johofz/Reflow_Oven_V2/Hardware/Reflow_Ofen_V2.kicad_pcb

## KiCad design Hardware/Reflow_Ofen_V2.kicad_pcb (2021-04-04)

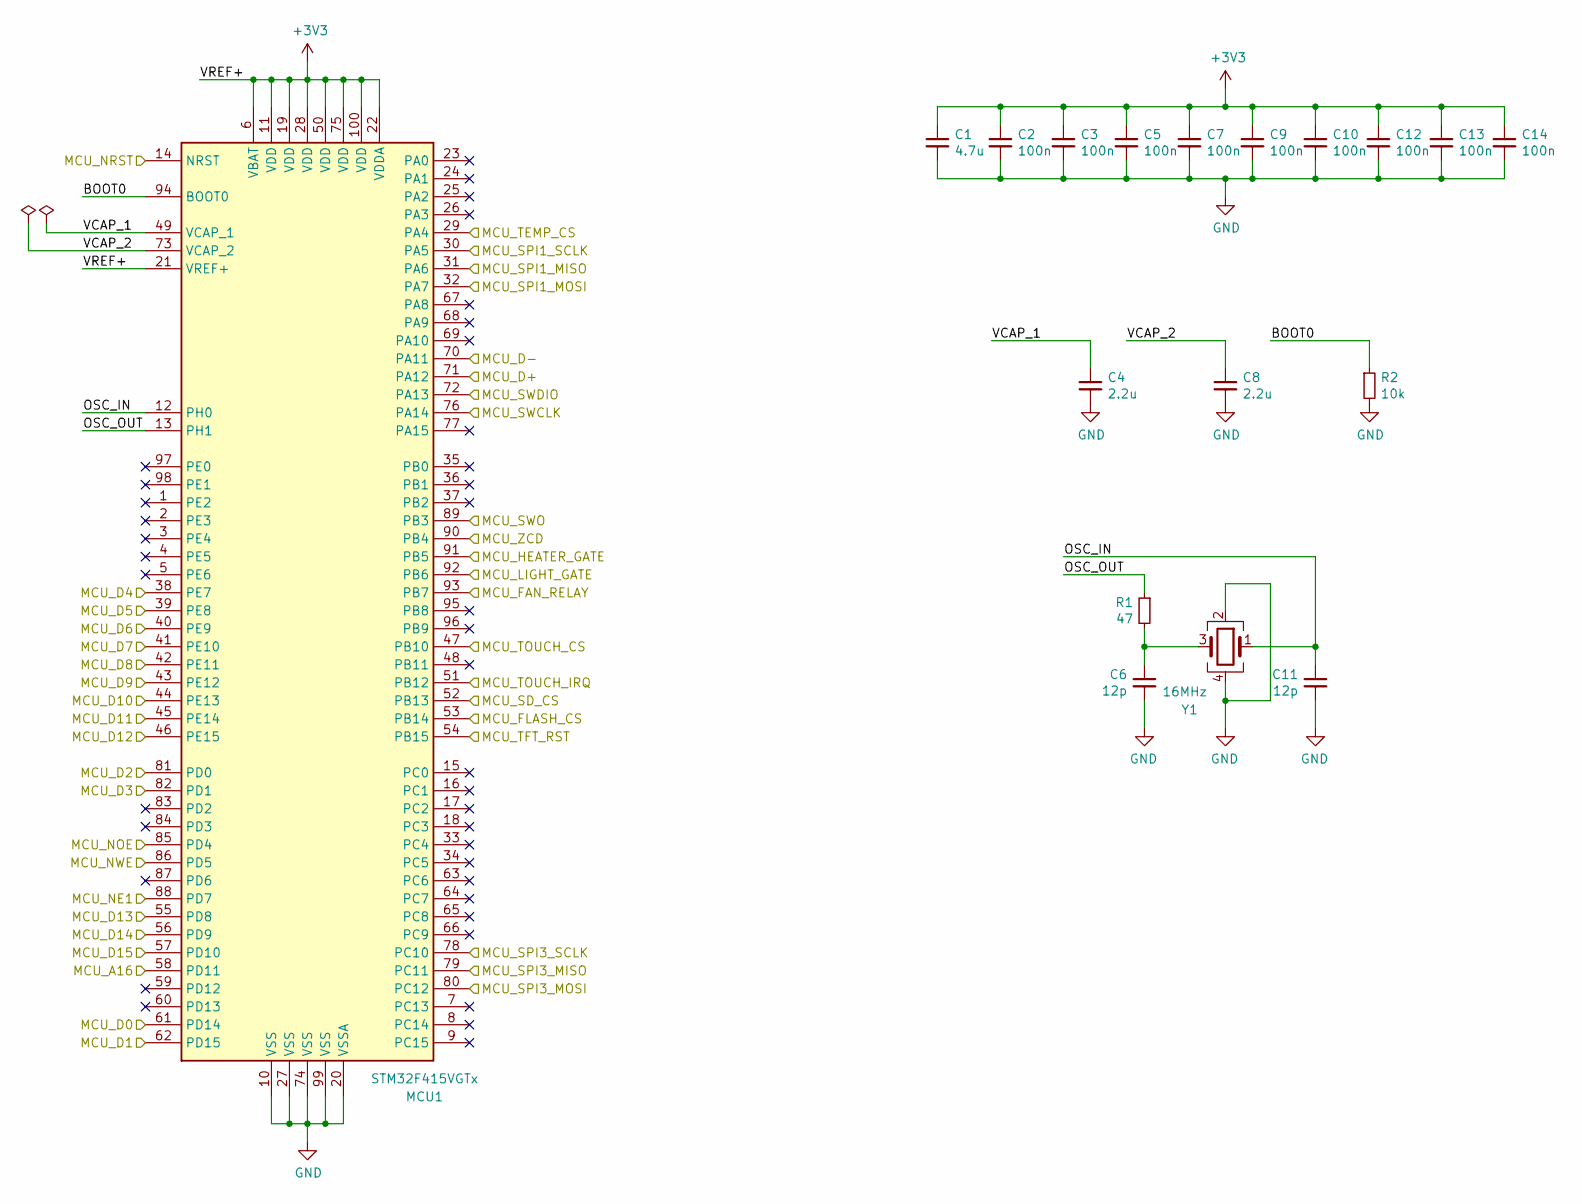
[picture p1: schematic STMF415VGT6.sch]

Parts:
C1: 4.7u; C_0603_1608Metric; LCSC C19666
C2, C3, C5, C7, C9, C10, C12, C13, C14: 100n; C_0402_1005Metric; LCSC C1525
C4, C8: 2.2u; C_0603_1608Metric; LCSC C23630
C6, C11: 12p; C_0402_1005Metric; LCSC C1547
MCU1: STM32F415VGTx; LQFP-100_14x14mm_P0.5mm; LCSC C118210
R1: 47; R_0402_1005Metric; LCSC C25118
R2: 10k; R_0402_1005Metric; LCSC C25744
Y1: 16MHz; Crystal_SMD_3225-4Pin_3.2x2.5mm; LCSC C13738

Connections:
/Connectors/CONN_D+: MCU1.71 (PA12); also elsewhere on the board
/Connectors/CONN_D-: MCU1.70 (PA11); also elsewhere on the board
/Connectors/CONN_NRST: MCU1.14 (NRST); also elsewhere on the board
/Connectors/CONN_SWCLK: MCU1.76 (PA14); also elsewhere on the board
/Connectors/CONN_SWDIO: MCU1.72 (PA13); also elsewhere on the board
/Connectors/CONN_SWO: MCU1.89 (PB3); also elsewhere on the board
/FLASH_CS: MCU1.53 (PB14); also elsewhere on the board
/Power-Control/FAN_GATE: MCU1.93 (PB7); also elsewhere on the board
/Power-Control/HEATER_GATE: MCU1.91 (PB5); also elsewhere on the board
/Power-Control/LIGHT_GATE: MCU1.92 (PB6); also elsewhere on the board
/SD_CS: MCU1.52 (PB13); also elsewhere on the board
/SPI3_MISO: MCU1.79 (PC11); also elsewhere on the board
/SPI3_MOSI: MCU1.80 (PC12); also elsewhere on the board
/SPI3_SCLK: MCU1.78 (PC10); also elsewhere on the board
/STMF415VGT6/BOOT0: MCU1.94 (BOOT0), R2.1
/STMF415VGT6/MCU_A16: MCU1.58 (PD11); also elsewhere on the board
/STMF415VGT6/MCU_D0: MCU1.61 (PD14); also elsewhere on the board
/STMF415VGT6/MCU_D1: MCU1.62 (PD15); also elsewhere on the board
/STMF415VGT6/MCU_D2: MCU1.81 (PD0); also elsewhere on the board
/STMF415VGT6/MCU_D3: MCU1.82 (PD1); also elsewhere on the board
/STMF415VGT6/MCU_D4: MCU1.38 (PE7); also elsewhere on the board
/STMF415VGT6/MCU_D5: MCU1.39 (PE8); also elsewhere on the board
/STMF415VGT6/MCU_D6: MCU1.40 (PE9); also elsewhere on the board
/STMF415VGT6/MCU_D7: MCU1.41 (PE10); also elsewhere on the board
/STMF415VGT6/MCU_D8: MCU1.42 (PE11); also elsewhere on the board
/STMF415VGT6/MCU_D9: MCU1.43 (PE12); also elsewhere on the board
/STMF415VGT6/MCU_D10: MCU1.44 (PE13); also elsewhere on the board
/STMF415VGT6/MCU_D11: MCU1.45 (PE14); also elsewhere on the board
/STMF415VGT6/MCU_D12: MCU1.46 (PE15); also elsewhere on the board
/STMF415VGT6/MCU_D13: MCU1.55 (PD8); also elsewhere on the board
/STMF415VGT6/MCU_D14: MCU1.56 (PD9); also elsewhere on the board
/STMF415VGT6/MCU_D15: MCU1.57 (PD10); also elsewhere on the board
/STMF415VGT6/MCU_NE1: MCU1.88 (PD7); also elsewhere on the board
/STMF415VGT6/MCU_NOE: MCU1.85 (PD4); also elsewhere on the board
/STMF415VGT6/MCU_NWE: MCU1.86 (PD5); also elsewhere on the board
/STMF415VGT6/MCU_SPI1_MISO: MCU1.31 (PA6); also elsewhere on the board
/STMF415VGT6/MCU_SPI1_SCLK: MCU1.30 (PA5); also elsewhere on the board
/STMF415VGT6/MCU_TEMP_CS: MCU1.29 (PA4); also elsewhere on the board
/STMF415VGT6/MCU_TFT_RST: MCU1.54 (PB15); also elsewhere on the board
/STMF415VGT6/MCU_ZCD: MCU1.90 (PB4); also elsewhere on the board
/STMF415VGT6/OSC_IN: C11.1, MCU1.12 (PH0), Y1.1
/STMF415VGT6/OSC_OUT: MCU1.13 (PH1), R1.1
/STMF415VGT6/VCAP_1: C4.1, MCU1.49 (VCAP_1)
/STMF415VGT6/VCAP_2: C8.1, MCU1.73 (VCAP_2)
/TOUCH_CS: MCU1.47 (PB10); also elsewhere on the board
/TOUCH_IRQ: MCU1.51 (PB12); also elsewhere on the board
GND: C1.2, C2.2, C3.2, C4.2, C5.2, C6.2, C7.2, C8.2, C9.2, C10.2, C11.2, C12.2, C13.2, C14.2, MCU1.10 (VSS), MCU1.20 (VSSA), MCU1.27 (VSS), MCU1.74 (VSS), MCU1.99 (VSS), R2.2, Y1.2, Y1.4; also elsewhere on the board
unnamed: C6.1, R1.2, Y1.3

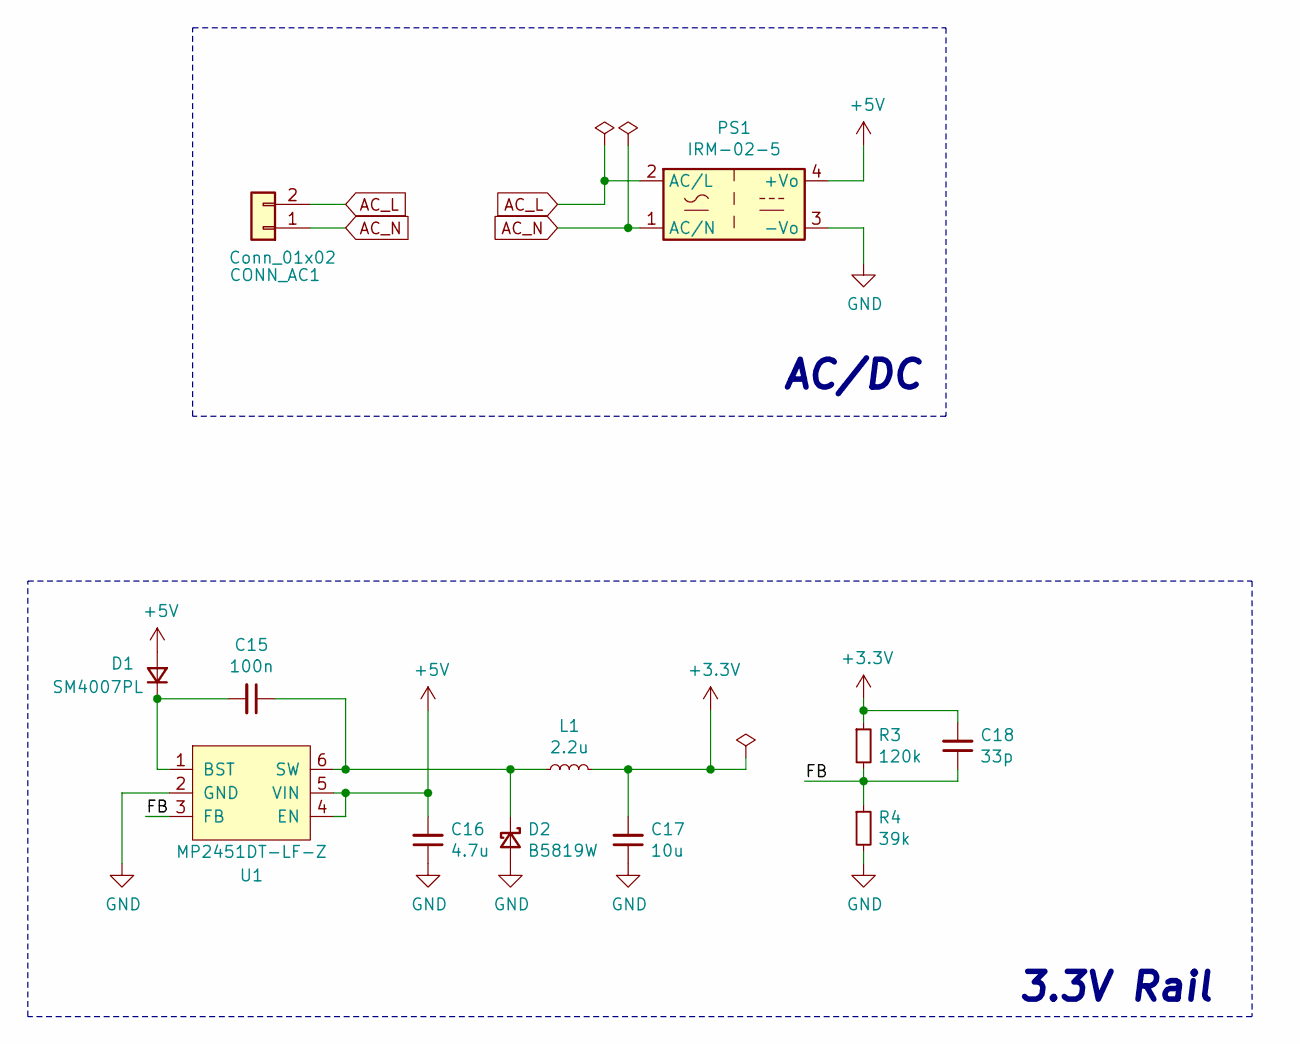
[picture p2: schematic Power.sch]

Parts:
C15: 100n; C_0402_1005Metric; LCSC C1525
C16: 4.7u; C_0805_2012Metric; LCSC C1779
C17: 10u; C_0805_2012Metric; LCSC C15850
C18: 33p; C_0603_1608Metric; LCSC C1663
CONN_AC1: Conn_01x02; TerminalBlock_Wuerth_691311400102_P7.62mm; LCSC C8422
D1: SM4007PL; D_SOD-123F; LCSC C64898
D2: B5819W; D_SOD-123; LCSC C8598
L1: 2.2u; L_Sunlord_MWSA0518_5.4x5.2mm; LCSC C408345
PS1: IRM-02-5; Converter_ACDC_MeanWell_IRM-02-xx_THT
R3: 120k; R_0805_2012Metric; LCSC C17436
R4: 39k; R_0805_2012Metric; LCSC C25826
U1: MP2451DT-LF-Z; TSOT-23-6; LCSC C85285

Connections:
+5V: C16.2, D1.2 (A), PS1.4 (+Vo), U1.4 (EN), U1.5 (VIN); also elsewhere on the board
/Power/FB: C18.1, R3.2, R4.1, U1.3 (FB)
AC_L: CONN_AC1.2, PS1.2 (AC/L); also elsewhere on the board
AC_N: CONN_AC1.1, PS1.1 (AC/N); also elsewhere on the board
GND: C16.1, C17.1, D2.2 (A), PS1.3 (-Vo), R4.2, U1.2 (GND); also elsewhere on the board
unnamed: C15.1, D2.1 (K), L1.1, U1.6 (SW)
unnamed: C15.2, D1.1 (K), U1.1 (BST)

Notes on the sheet:
3.3V Rail
AC/DC

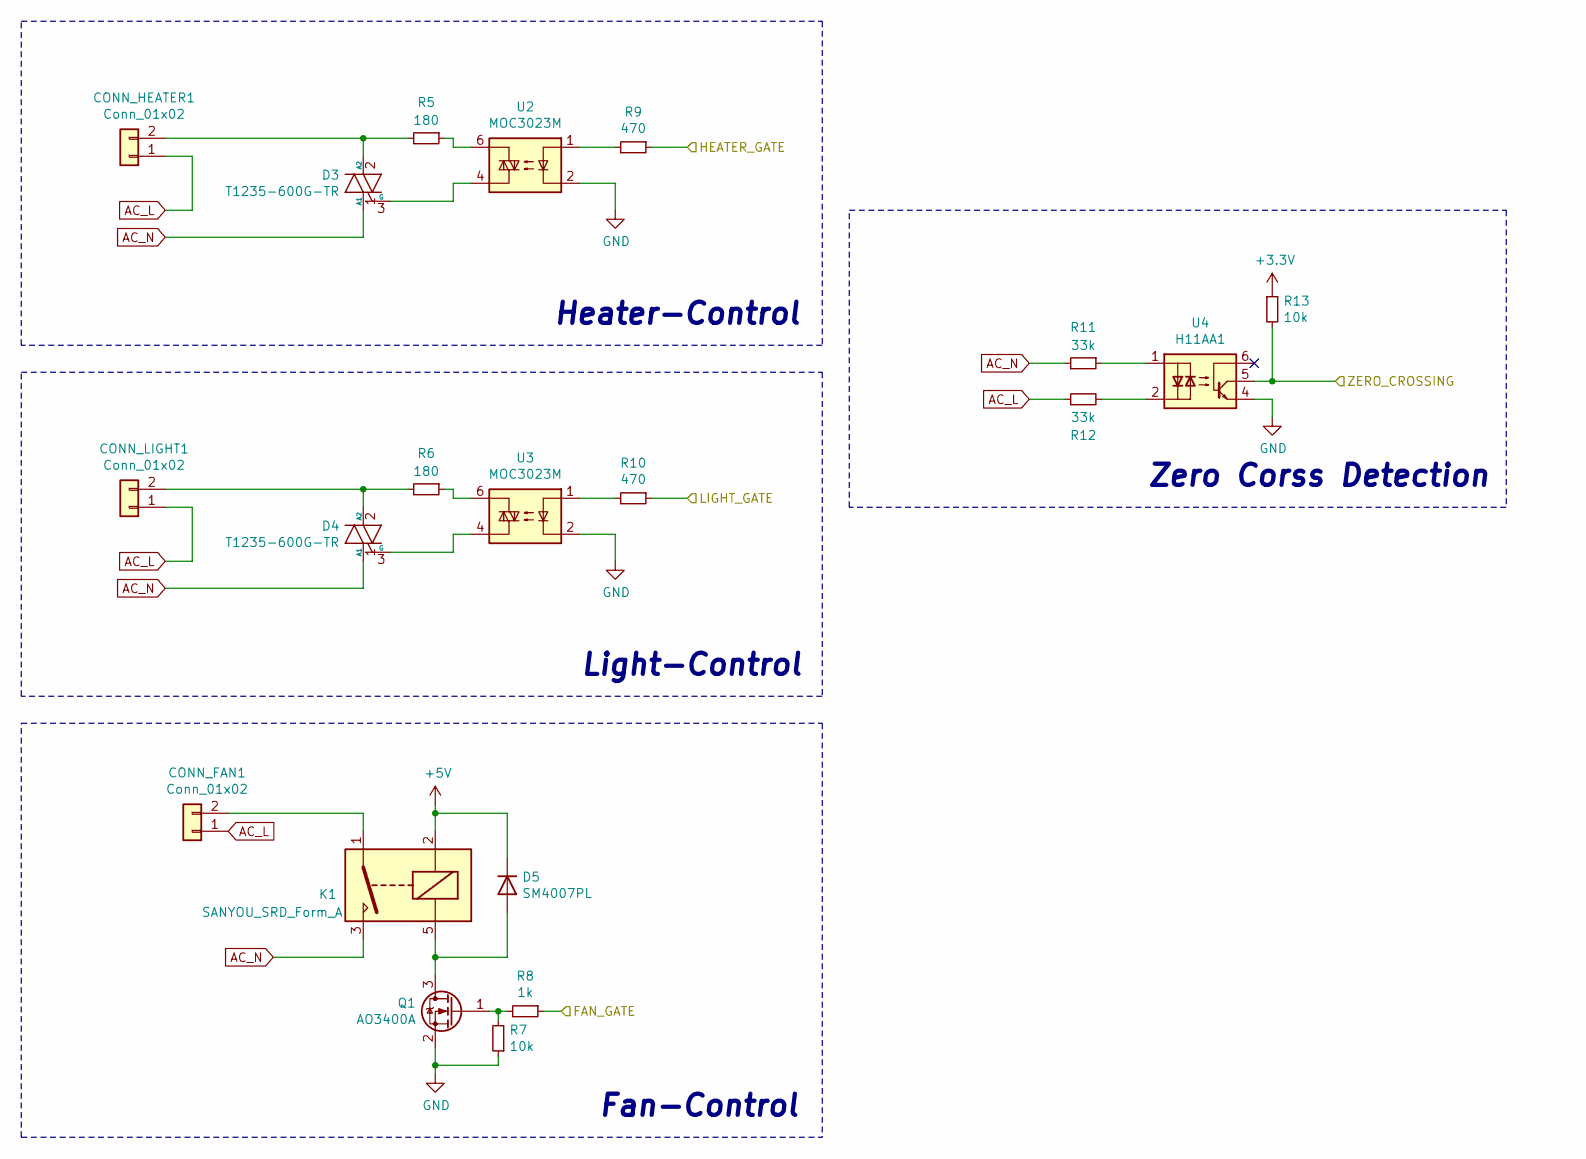
[picture p3: schematic Power-Control.sch]

Parts:
CONN_FAN1: Conn_01x02; TerminalBlock_Wuerth_691311400102_P7.62mm; LCSC C8422
CONN_HEATER1: Conn_01x02; TerminalBlock_Wuerth_691311400102_P7.62mm; LCSC C8422
CONN_LIGHT1: Conn_01x02; TerminalBlock_Wuerth_691311400102_P7.62mm; LCSC C8422
D3: T1235-600G-TR; TO-220-3_Vertical
D4: T1235-600G-TR; TO-263-2; LCSC C155555
D5: SM4007PL; D_SOD-123F; LCSC C64898
K1: SANYOU_SRD_Form_A; Relay_SPST_SANYOU_SRD_Series_Form_A; LCSC C35449
Q1: AO3400A; SOT-23; LCSC C20917
R5, R6: 180; R_0805_2012Metric; LCSC C25270
R7, R13: 10k; R_0603_1608Metric; LCSC C25804
R8: 1k; R_0603_1608Metric; LCSC C21190
R9, R10: 470; R_0603_1608Metric; LCSC C25117
R11, R12: 33k; R_0805_2012Metric; LCSC C17633
U2, U3: MOC3023M; SMDIP-6_W9.53mm; LCSC C40701
U4: H11AA1; SMDIP-6_W9.53mm; LCSC C258253

Connections:
+5V: D5.1 (K), K1.2; also elsewhere on the board
/Power-Control/FAN_GATE: R8.1; also elsewhere on the board
/Power-Control/HEATER_GATE: R9.1; also elsewhere on the board
/Power-Control/LIGHT_GATE: R10.1; also elsewhere on the board
/STMF415VGT6/MCU_ZCD: R13.2, U4.5; also elsewhere on the board
AC_L: CONN_FAN1.1, CONN_HEATER1.1, CONN_LIGHT1.1, R12.1; also elsewhere on the board
AC_N: D3.1 (A1), D4.1 (A1), K1.3, R11.2; also elsewhere on the board
GND: Q1.2 (S), R7.1, U2.2, U3.2, U4.4; also elsewhere on the board
unnamed: CONN_FAN1.2, K1.1
unnamed: CONN_HEATER1.2, D3.2 (A2), R5.2
unnamed: CONN_LIGHT1.2, D4.2 (A2), R6.2
unnamed: D3.3 (G), U2.4
unnamed: D4.3 (G), U3.4
unnamed: D5.2 (A), K1.5, Q1.3 (D)
unnamed: Q1.1 (G), R7.2, R8.2
unnamed: R5.1, U2.6
unnamed: R6.1, U3.6
unnamed: R9.2, U2.1
unnamed: R10.2, U3.1
unnamed: R11.1, U4.1
unnamed: R12.2, U4.2

Notes on the sheet:
Heater-Control
Zero Corss Detection
Light-Control
Fan-Control

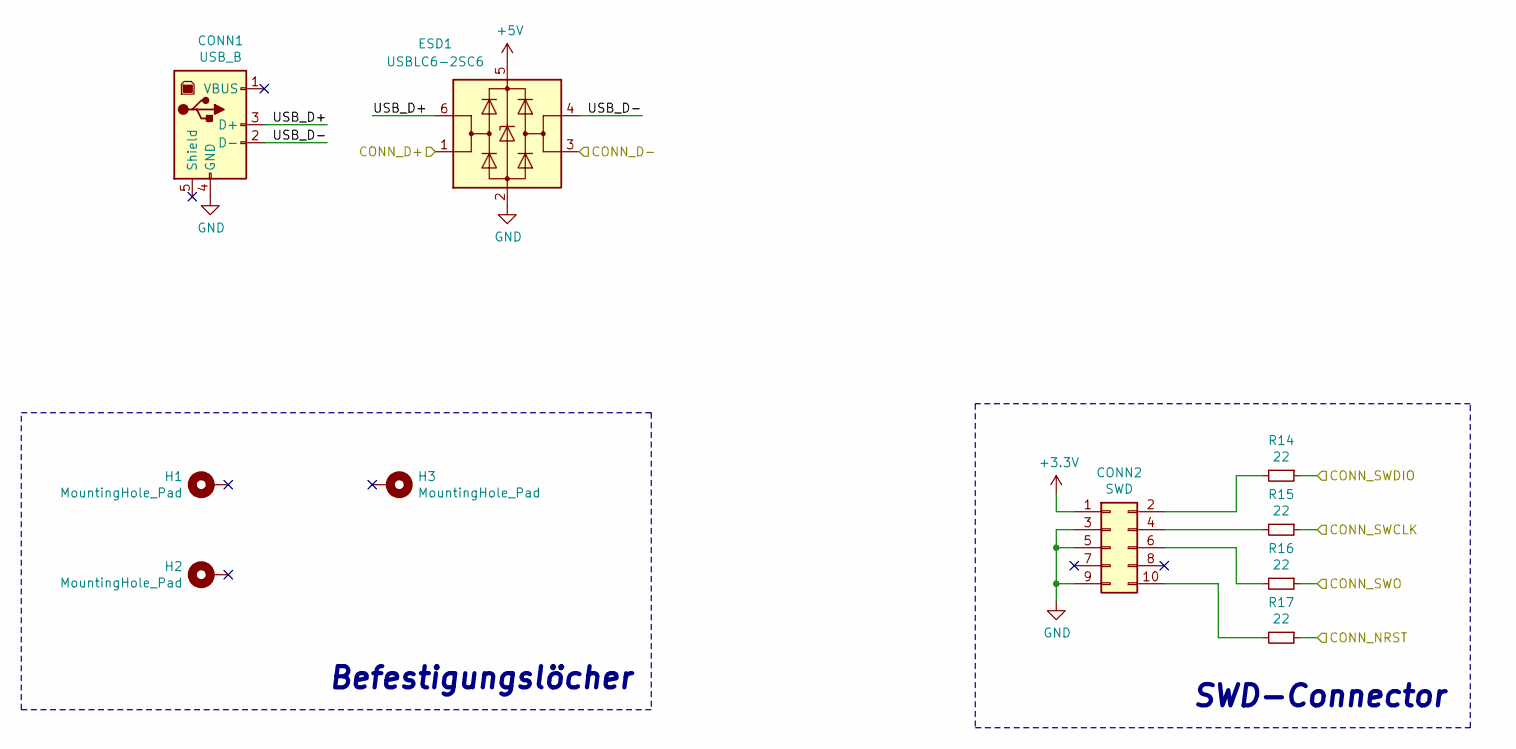
[picture p4: schematic Connectors.sch]

Parts:
CONN1: USB_B; USB_B_OST_USB-B1HSxx_Horizontal
CONN2: SWD; PinHeader_2x05_P1.27mm_Vertical_SMD
ESD1: USBLC6-2SC6; SOT-23-6; LCSC C7519
H1, H2, H3: MountingHole_Pad; MountingHole_5.3mm_M5_Pad_Via
R14, R15, R16, R17: 22; R_0402_1005Metric; LCSC C25092

Connections:
+5V: ESD1.5 (VBUS); also elsewhere on the board
/Connectors/CONN_D+: ESD1.1 (I/O1); also elsewhere on the board
/Connectors/CONN_D-: ESD1.3 (I/O2); also elsewhere on the board
/Connectors/CONN_NRST: R17.1; also elsewhere on the board
/Connectors/CONN_SWCLK: R15.1; also elsewhere on the board
/Connectors/CONN_SWDIO: R14.1; also elsewhere on the board
/Connectors/CONN_SWO: R16.1; also elsewhere on the board
/Connectors/USB_D+: CONN1.3 (D+), ESD1.6 (I/O1)
/Connectors/USB_D-: CONN1.2 (D-), ESD1.4 (I/O2)
GND: CONN1.4 (GND), CONN2.3, CONN2.5, CONN2.9, ESD1.2 (GND); also elsewhere on the board
unnamed: CONN2.2, R14.2
unnamed: CONN2.4, R15.2
unnamed: CONN2.6, R16.2
unnamed: CONN2.10, R17.2

Notes on the sheet:
SWD-Connector
Befestigungslöcher

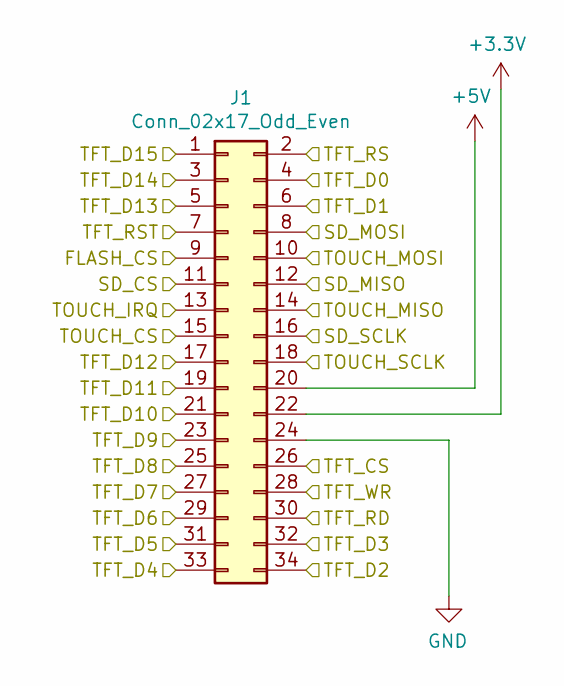
[picture p5: schematic 16Bit_TFT_Touch.sch]

Parts:
J1: Conn_02x17_Odd_Even; PinHeader_2x17_P1.27mm_Vertical

Connections:
+5V: J1.20; also elsewhere on the board
/FLASH_CS: J1.9; also elsewhere on the board
/SD_CS: J1.11; also elsewhere on the board
/SPI3_MISO: J1.12, J1.14; also elsewhere on the board
/SPI3_MOSI: J1.8, J1.10; also elsewhere on the board
/SPI3_SCLK: J1.16, J1.18; also elsewhere on the board
/STMF415VGT6/MCU_A16: J1.2; also elsewhere on the board
/STMF415VGT6/MCU_D0: J1.4; also elsewhere on the board
/STMF415VGT6/MCU_D1: J1.6; also elsewhere on the board
/STMF415VGT6/MCU_D2: J1.34; also elsewhere on the board
/STMF415VGT6/MCU_D3: J1.32; also elsewhere on the board
/STMF415VGT6/MCU_D4: J1.33; also elsewhere on the board
/STMF415VGT6/MCU_D5: J1.31; also elsewhere on the board
/STMF415VGT6/MCU_D6: J1.29; also elsewhere on the board
/STMF415VGT6/MCU_D7: J1.27; also elsewhere on the board
/STMF415VGT6/MCU_D8: J1.25; also elsewhere on the board
/STMF415VGT6/MCU_D9: J1.23; also elsewhere on the board
/STMF415VGT6/MCU_D10: J1.21; also elsewhere on the board
/STMF415VGT6/MCU_D11: J1.19; also elsewhere on the board
/STMF415VGT6/MCU_D12: J1.17; also elsewhere on the board
/STMF415VGT6/MCU_D13: J1.5; also elsewhere on the board
/STMF415VGT6/MCU_D14: J1.3; also elsewhere on the board
/STMF415VGT6/MCU_D15: J1.1; also elsewhere on the board
/STMF415VGT6/MCU_NE1: J1.26; also elsewhere on the board
/STMF415VGT6/MCU_NOE: J1.30; also elsewhere on the board
/STMF415VGT6/MCU_NWE: J1.28; also elsewhere on the board
/STMF415VGT6/MCU_TFT_RST: J1.7; also elsewhere on the board
/TOUCH_CS: J1.15; also elsewhere on the board
/TOUCH_IRQ: J1.13; also elsewhere on the board
GND: J1.24; also elsewhere on the board

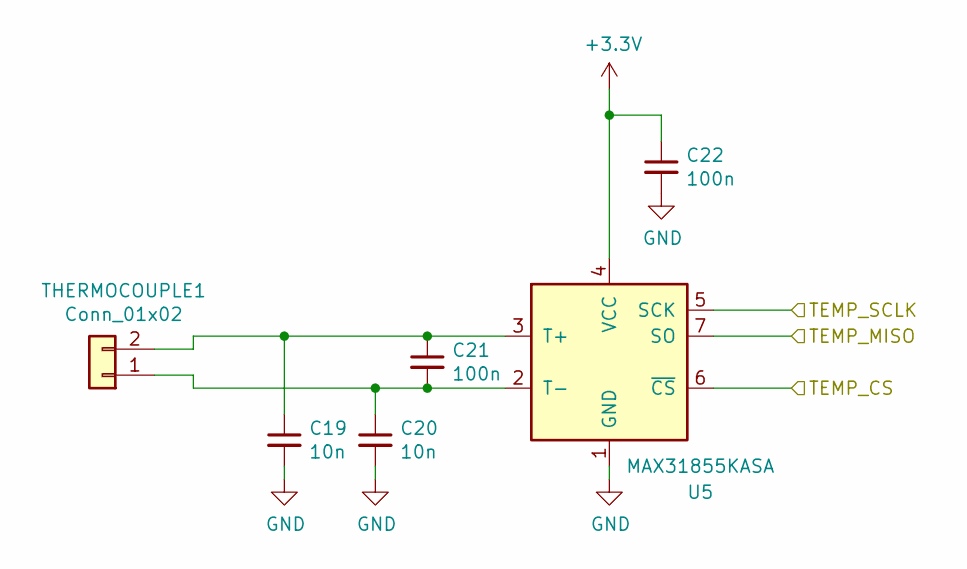
[picture p6: schematic Thermoelement.sch]

Parts:
C19, C20: 10n; C_0402_1005Metric; LCSC C15195
C21, C22: 100n; C_0402_1005Metric; LCSC C1525
THERMOCOUPLE1: Conn_01x02; TerminalBlock_bornier-2_P5.08mm; LCSC C395868
U5: MAX31855KASA; SOIC-8_3.9x4.9mm_P1.27mm; LCSC C52028

Connections:
/STMF415VGT6/MCU_SPI1_MISO: U5.7 (SO); also elsewhere on the board
/STMF415VGT6/MCU_SPI1_SCLK: U5.5 (SCK); also elsewhere on the board
/STMF415VGT6/MCU_TEMP_CS: U5.6 (~CS~); also elsewhere on the board
GND: C19.2, C20.2, C22.2, U5.1 (GND); also elsewhere on the board
unnamed: C19.1, C21.1, THERMOCOUPLE1.2, U5.3 (T+)
unnamed: C20.1, C21.2, THERMOCOUPLE1.1, U5.2 (T-)

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
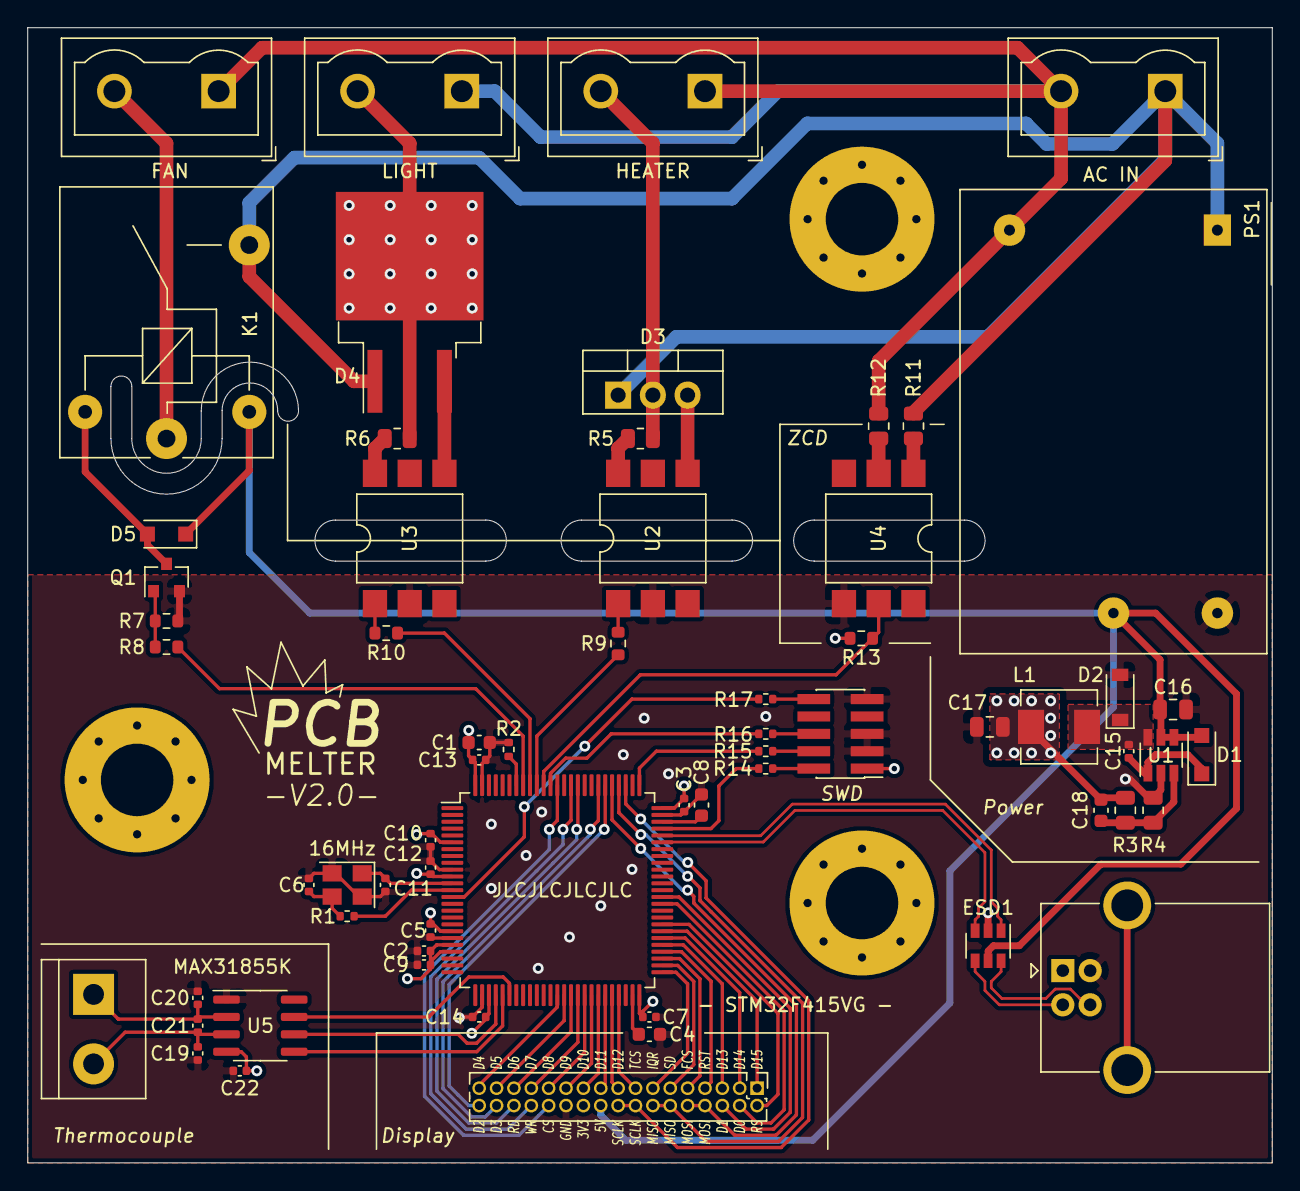
[picture p7: board Reflow_Ofen_V2.kicad_pcb from above]

Board: 4 copper layers, 91.0 x 83.0 mm, 67 parts (0 on the bottom side), 76 nets.
