johofz/Reflow_Oven_V2/Firmware/F415VG/F415VG.ioc

PH0-OSC_IN.Signal=RCC_OSC_IN
Mcu.UserName=STM32F415VGTx
PC10.Signal=SPI3_SCK
PC12.Signal=SPI3_MOSI
PB14.GPIO_Label=SD_CS
PB6.GPIO_Label=LIGHT
PB13.GPIO_Label=FLASH_CS
PB13.Signal=GPIO_Output
PB15.Signal=GPIO_Output
PA12.Signal=USB_OTG_FS_DP
PD4.Signal=FSMC_NOE
PB6.Signal=GPIO_Output
PD0.Signal=FSMC_D2
PD8.Signal=FSMC_D13
PB12.GPIO_Label=TOUCH_IQR
PE13.Signal=FSMC_D10
PE9.Signal=FSMC_D6
PB7.Signal=GPIO_Output
PE10.Signal=FSMC_D7
PB7.GPIO_Label=FAN
PA6.Signal=SPI1_MISO
PB5.GPIO_Label=HEATER
PE7.Signal=FSMC_D4
PA4.GPIO_Label=TEMP_CS
PD15.Signal=FSMC_D1
PB4.Signal=GPXTI4
PC11.Signal=SPI3_MISO
PD7.Signal=FSMC_NE1
PD1.Signal=FSMC_D3
PD5.Signal=FSMC_NWE
PD9.Signal=FSMC_D14
PD10.Signal=FSMC_D15
PA13.Signal=SYS_JTMS-SWDIO
PB10.GPIO_Label=TOUCH_CS
PE11.Signal=FSMC_D8
PB10.Signal=GPIO_Output
PB14.Signal=GPIO_Output
PA5.Signal=SPI1_SCK
PE14.Signal=FSMC_D11
PE15.Signal=FSMC_D12
PB4.GPIO_Label=ZCD
PB15.GPIO_Label=TFT_RST
PE8.Signal=FSMC_D5
PH1-OSC_OUT.Signal=RCC_OSC_OUT
PE12.Signal=FSMC_D9
PD14.Signal=FSMC_D0
PB3.Signal=SYS_JTDO-SWO
PA4.Signal=GPIO_Output
PB5.Signal=GPIO_Output
PD11.Signal=FSMC_A16
PA11.Signal=USB_OTG_FS_DM
PA14.Signal=SYS_JTCK-SWCLK
PB12.Signal=GPXTI12
PA7.Signal=SPI1_MOSI
