johofz/Reflow_Oven_V2/Firmware/F415VG/Core/Inc/main.h

#define TEMP_CS_Pin GPIO_PIN_4
#define TEMP_CS_GPIO_Port GPIOA
#define TOUCH_CS_Pin GPIO_PIN_10
#define TOUCH_CS_GPIO_Port GPIOB
#define TOUCH_IQR_Pin GPIO_PIN_12
#define TOUCH_IQR_GPIO_Port GPIOB
#define FLASH_CS_Pin GPIO_PIN_13
#define FLASH_CS_GPIO_Port GPIOB
#define SD_CS_Pin GPIO_PIN_14
#define SD_CS_GPIO_Port GPIOB
#define TFT_RST_Pin GPIO_PIN_15
#define TFT_RST_GPIO_Port GPIOB
#define ZCD_Pin GPIO_PIN_4
#define ZCD_GPIO_Port GPIOB
#define ZCD_EXTI_IRQn EXTI4_IRQn
#define HEATER_Pin GPIO_PIN_5
#define HEATER_GPIO_Port GPIOB
#define LIGHT_Pin GPIO_PIN_6
#define LIGHT_GPIO_Port GPIOB
#define FAN_Pin GPIO_PIN_7
#define FAN_GPIO_Port GPIOB
